ianm8/MBPR/Schematic_MBPR_2023-08-01.pdf

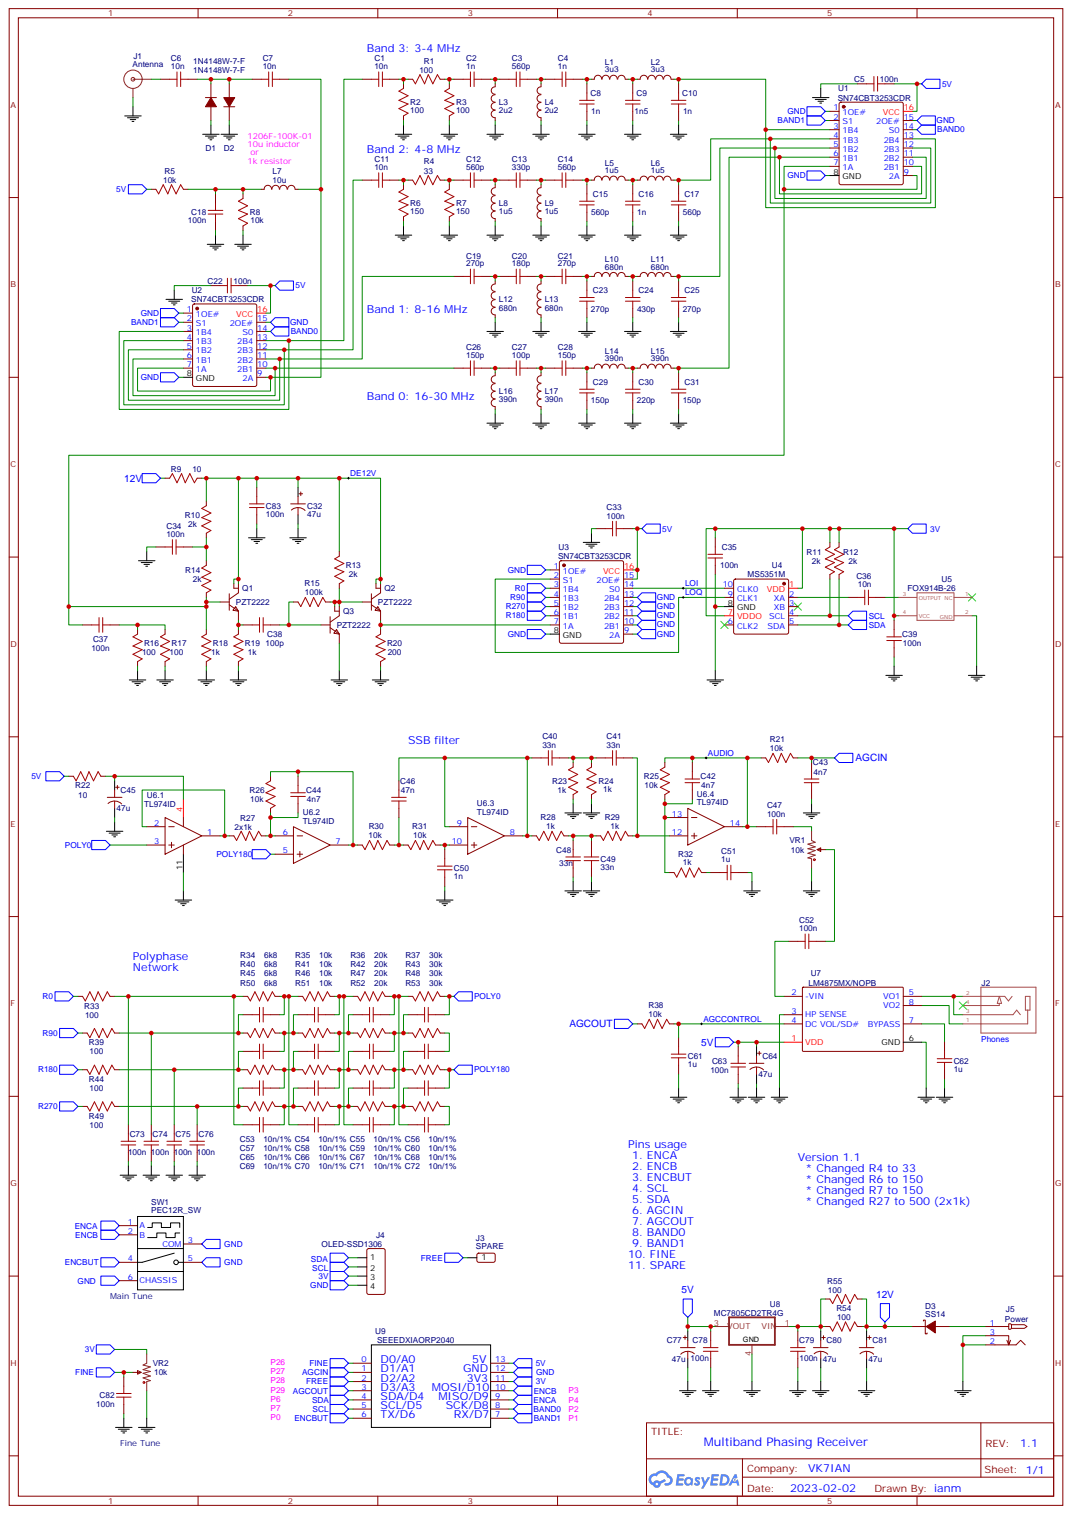
[picture p1: page 1]
