ianm8/MBPR/src/agc.h

#ifndef AGC_H
#define AGC_H

namespace AGC
{
  static const uint8_t agc_tab[2048] =
  {
    255u,
    255u,
    255u,
    255u,
    255u,
    255u,
    255u,
    255u,
    255u,
    255u,
    255u,
    255u,
    255u,
    255u,
    255u,
    255u,
    255u,
    255u,
    255u,
    255u,
    255u,
    255u,
    255u,
    255u,
    255u,
    255u,
    255u,
    255u,
    255u,
    255u,
    255u,
    255u,
    255u,
    255u,
    255u,
    255u,
    255u,
    255u,
    255u,
    255u,
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
  };

  static const int16_t dc(const int16_t in)
  {
    static int32_t s = 0;
    static int32_t x1 = 0;
    static int16_t y1 = 0;
    s -= x1;
    x1 = (int32_t)in << 16;
    s += x1 - ((int32_t)y1 << 11);
    return (y1 = s >> 16);
  }

  static const uint32_t peak(const int16_t sig)
  {
    static const uint32_t DECAY_POWER = 10u;
    static uint32_t p = 0;
    const uint32_t level = ((uint32_t)abs(sig))<<DECAY_POWER;
    if (level>p)
    {
      p = level;
    }
    else
    {
      if (p) p--;
    }
    return p>>DECAY_POWER;
  }

  static const uint8_t attenuation(const uint32_t peak)
  {
    // given the signal peak value,
    // return the appropriate attenuation value
    // watch out for the abs(-2048) edge case!
    return agc_tab[min(peak,2047u)];
  }
}
#endif
