ianm8/MBPR/(commit log)

2023-07-11 Schematic Version 1.1
    Schematic Version 1.1
2023-09-14 Fixed bug in AGC.
    An edge case in the AGC has been fixed.
    [MBPR.ino]
2023-09-14 Bug fixed in AGC.
    An edge case bug was fixed in the AGC.
    [agc.h]
2023-09-15 Circuit description
